deskpro256/DoggoLights/Images/packaged.jpeg

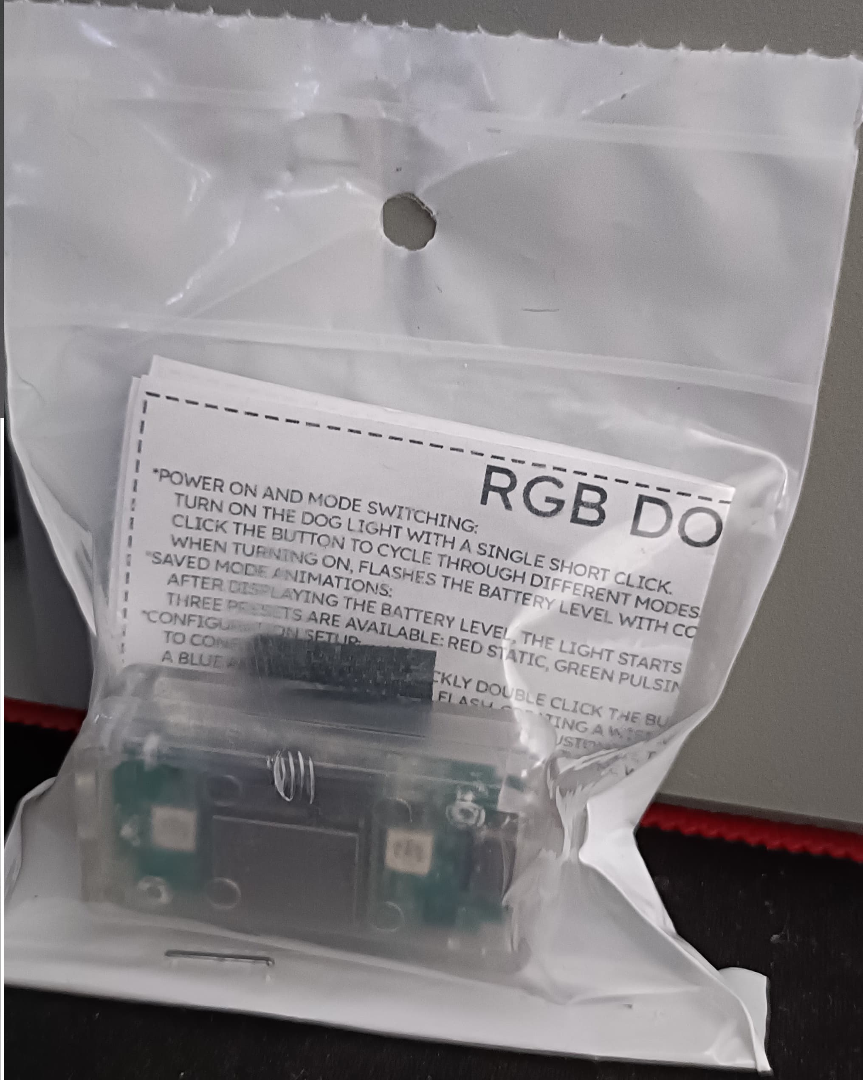
Images/packaged.jpeg
