deskpro256/DoggoLights/Images/WhatsApp Image 2024-01-11 at 19.58.03.jpeg

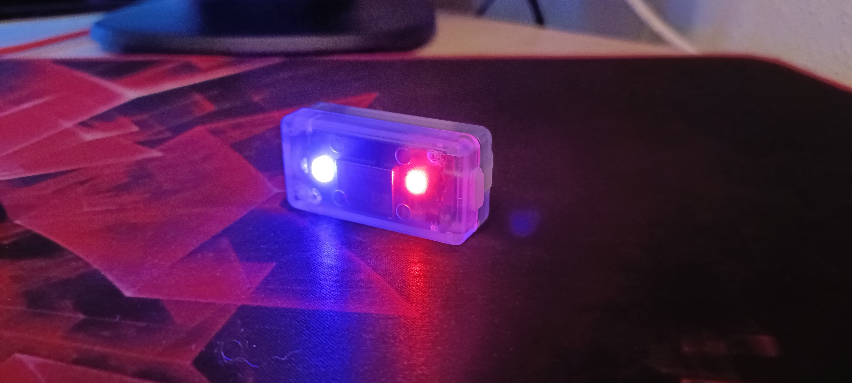
Images/WhatsApp Image 2024-01-11 at 19.58.03.jpeg
