deskpro256/DoggoLights/Hardware/Images/PCB-REV-1.png

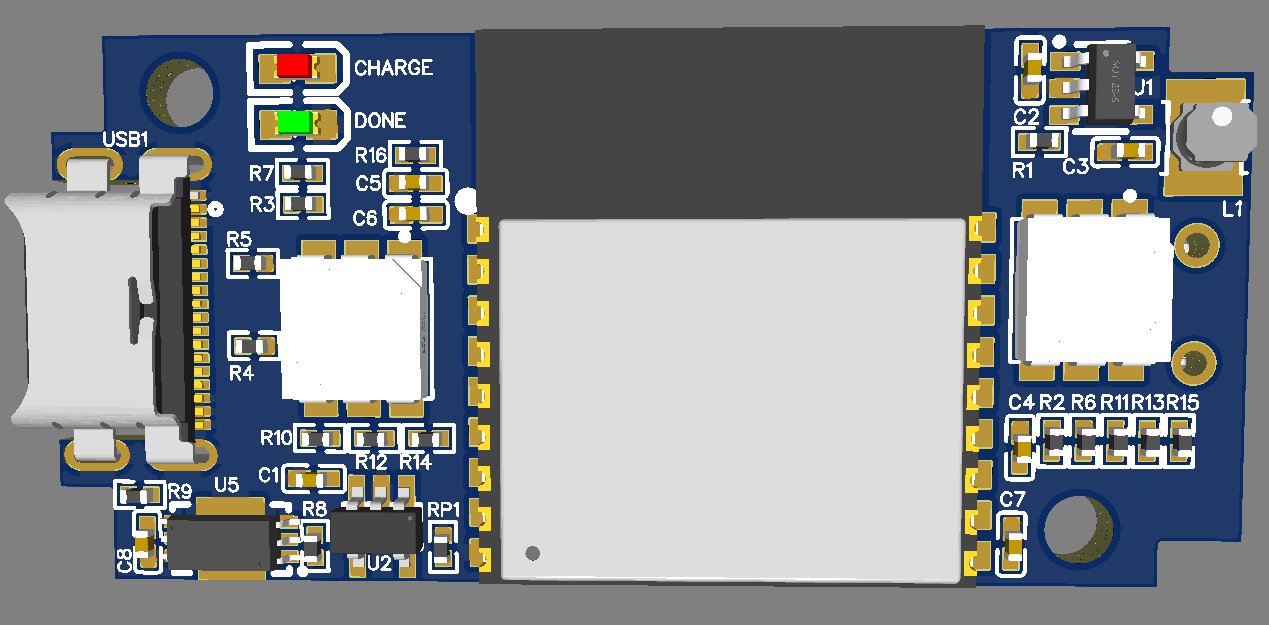
Hardware/Images/PCB-REV-1.png
