deskpro256/DoggoLights/Hardware/v2/2D-bot.png

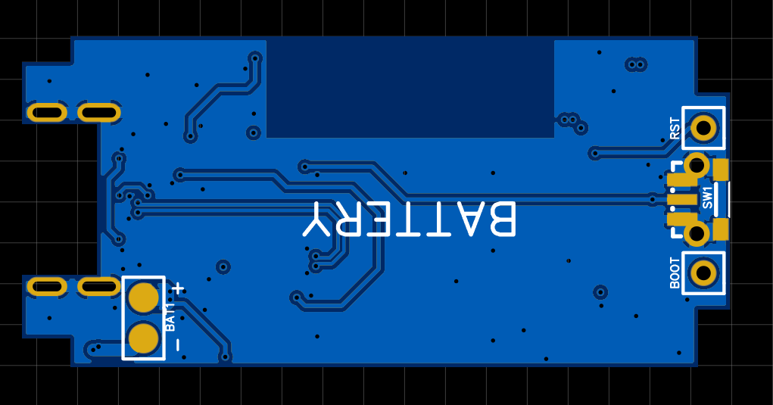
Hardware/v2/2D-bot.png
