deskpro256/DoggoLights/Hardware/v2/2D-top.png

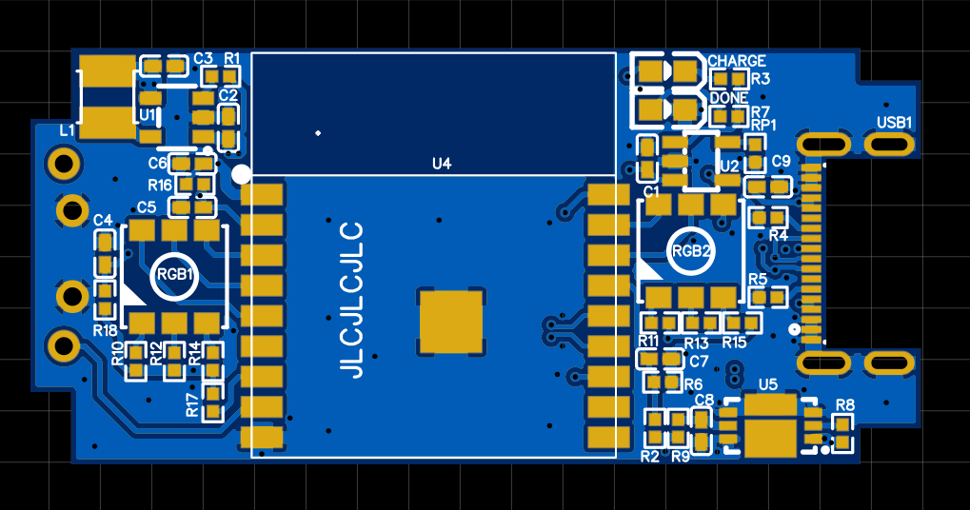
Hardware/v2/2D-top.png
