deskpro256/DoggoLights/Hardware/v2/3d-top-1.png

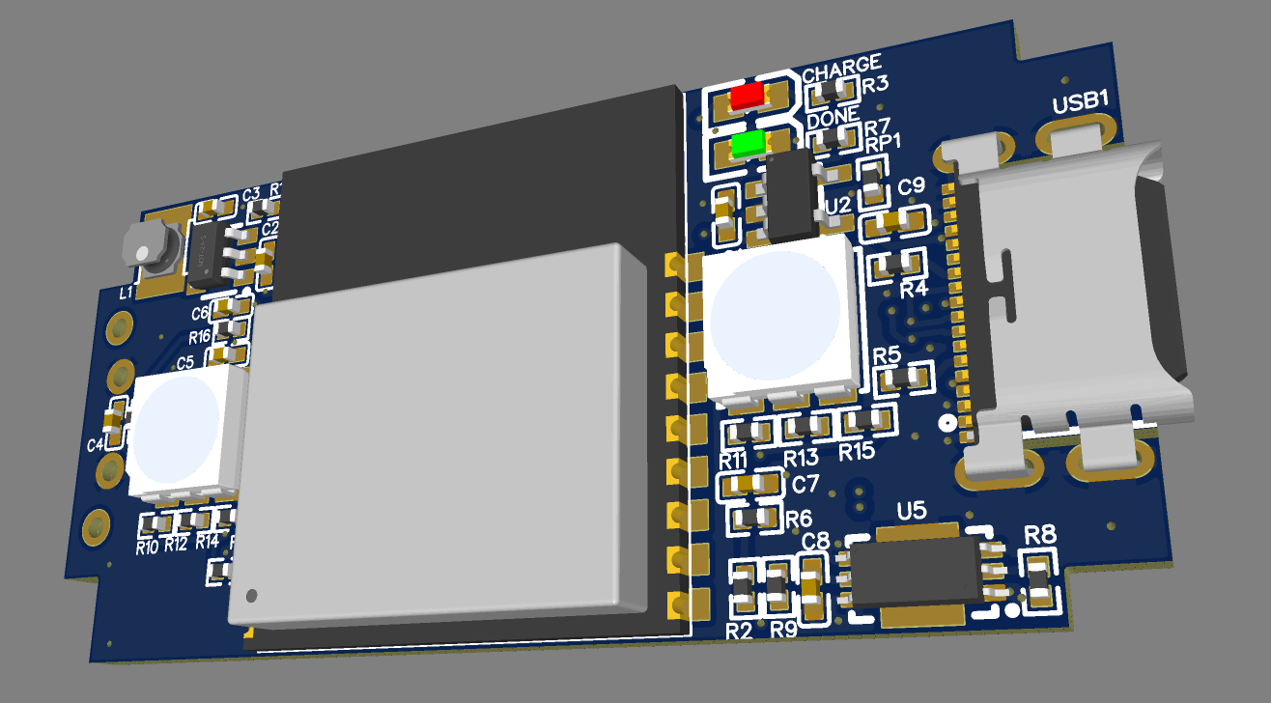
Hardware/v2/3d-top-1.png
