deskpro256/DoggoLights/Hardware/v2/3d-top-2.png

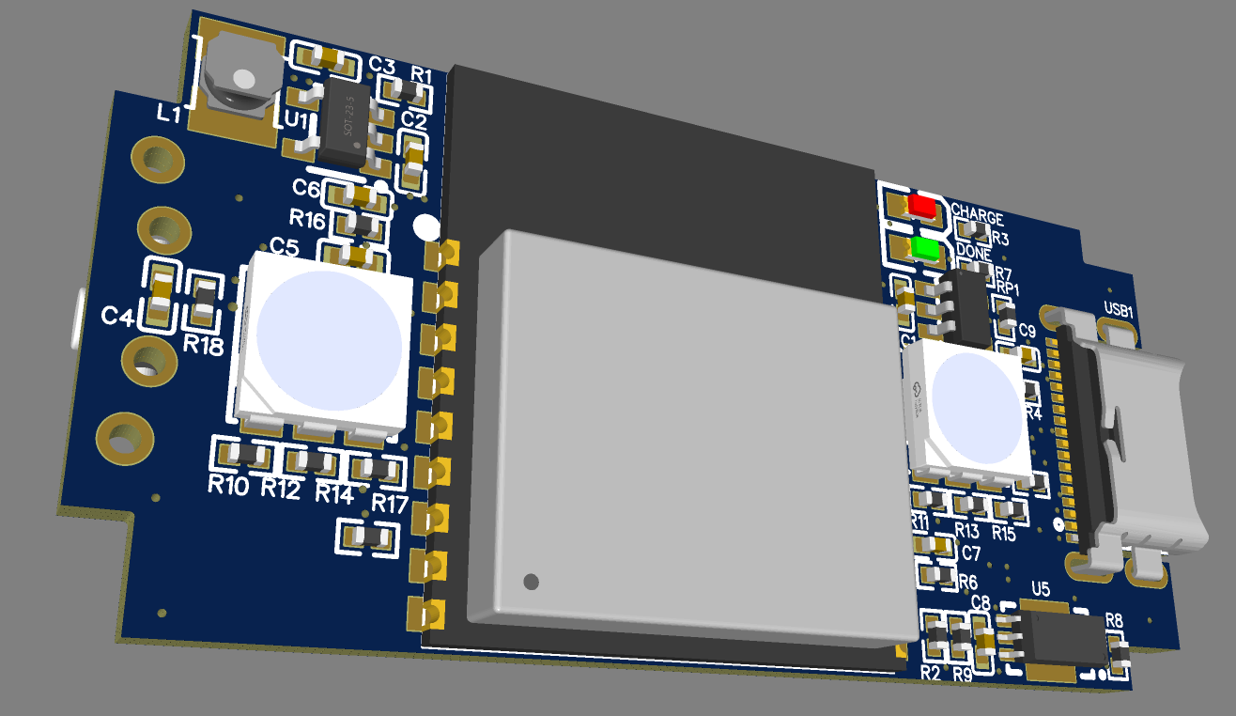
Hardware/v2/3d-top-2.png
