deskpro256/DoggoLights/Hardware/v2/Schematic_Doggo-Lights_2024-01-20.png

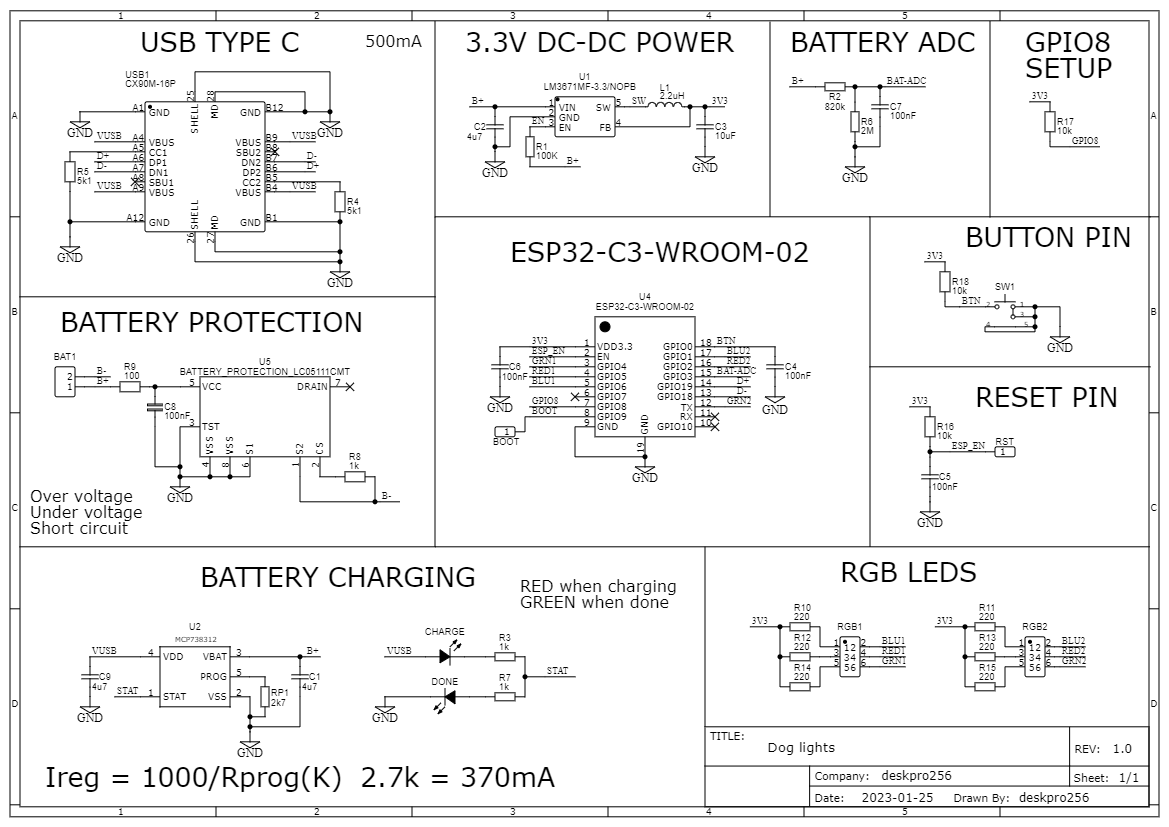
Hardware/v2/Schematic_Doggo-Lights_2024-01-20.png
