deskpro256/DoggoLights/Images/AI_doggo_w_light.png

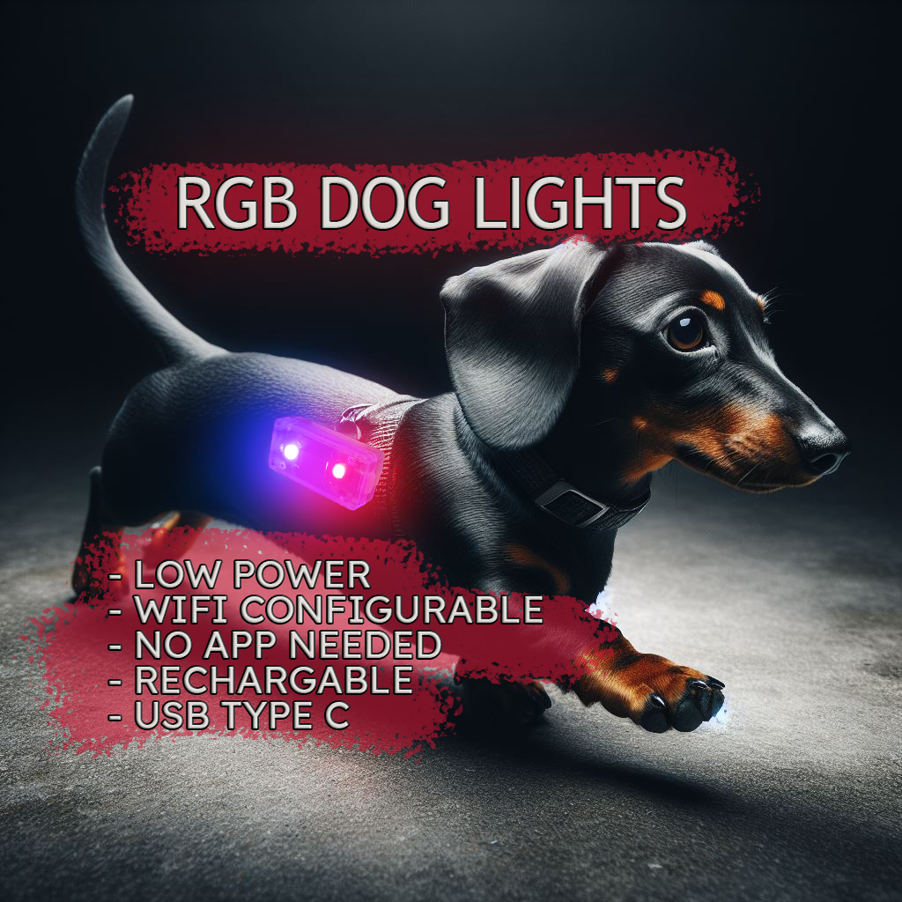
Images/AI_doggo_w_light.png
