deskpro256/DoggoLights/Images/dogLightsOrtoButton.png

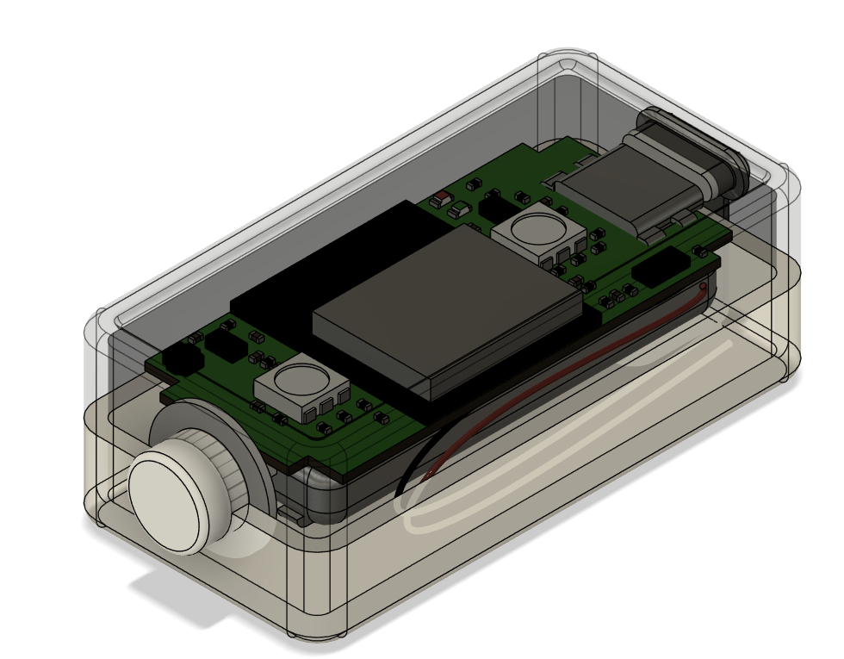
Images/dogLightsOrtoButton.png
