deskpro256/DoggoLights/Images/dogLightsOrtoUSB.png

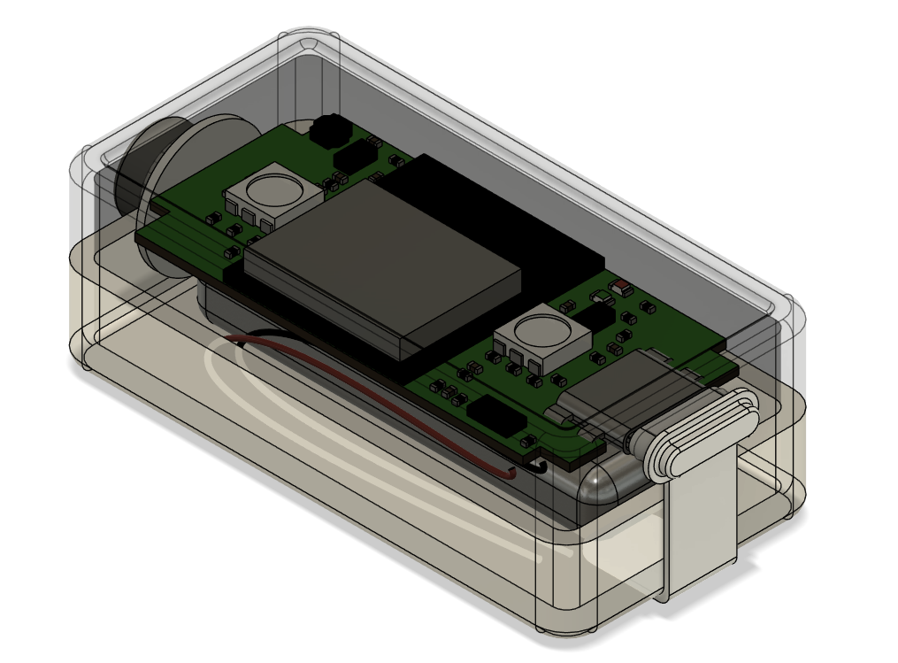
Images/dogLightsOrtoUSB.png
