deskpro256/DoggoLights/Images/dogLightsTop.png

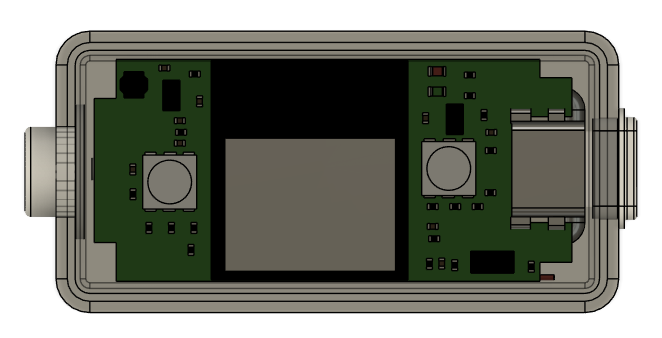
Images/dogLightsTop.png
