deskpro256/DoggoLights/Images/WhatsApp Image 2024-01-11 at 19.48.37.jpeg

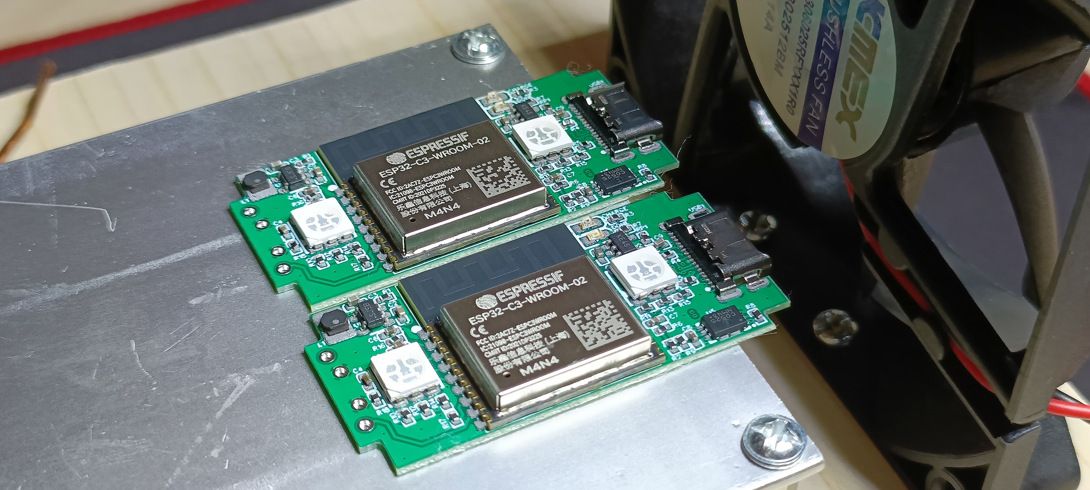
Images/WhatsApp Image 2024-01-11 at 19.48.37.jpeg
