deskpro256/DoggoLights/Images/WhatsApp Image 2024-01-20 at 23.52.01.jpeg

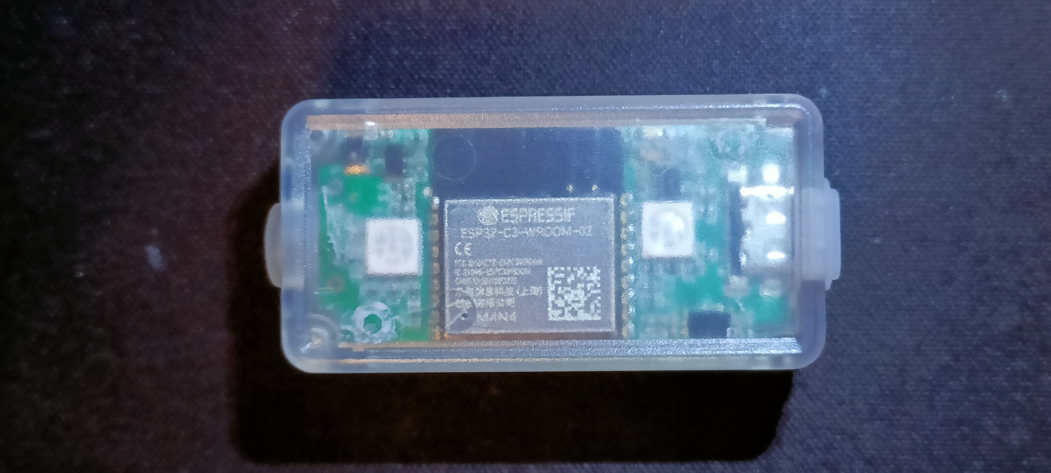
Images/WhatsApp Image 2024-01-20 at 23.52.01.jpeg
