deskpro256/DoggoLights/Specifications/SpecSheet.png

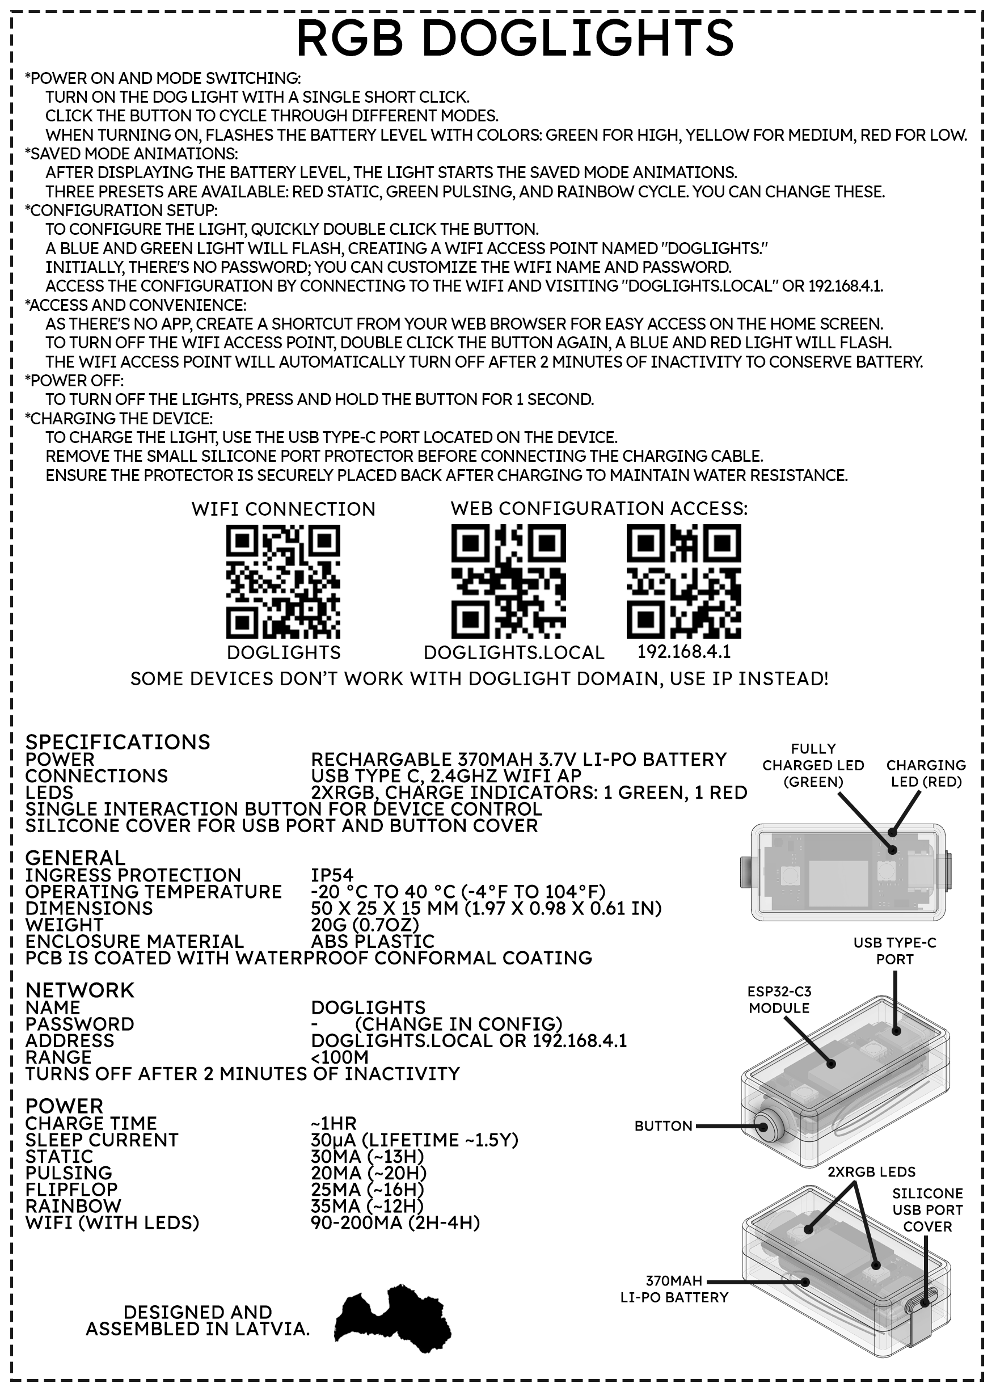
Specifications/SpecSheet.png
