deskpro256/DoggoLights/Hardware/v2/BOM_Doggo-Lights_2024-01-20.csv

ID | Name | Designator | Footprint | Quantity
1 | HDR-M-2.54_1x2 | BAT1 | HDR-M-2.54_1X2 | 1
2 | HDR-M-2.54_1x1 | BOOT,RST | HDR-M-2.54_1X1 | 2
3 | 4u7 | C1,C2,C9 | C0402 | 3
4 | 10uF | C3 | C0402 | 1
5 | 100nF | C4,C5,C6,C7,C8 | C0402 | 5
6 | LED-0805_R | CHARGE | LED-0603 | 1
7 | LED-0805_G | DONE | LED-0603 | 1
8 | 2.2uH | L1 | IND-SMD_L2.4-W2.4_NRH241XT | 1
9 | 100K | R1 | R0402 | 1
10 | 820k | R2 | R0402 | 1
11 | 1k | R3,R7,R8 | R0402 | 3
12 | 5k1 | R4,R5 | R0402 | 2
13 | 2M | R6 | R0402 | 1
14 | 100 | R9 | R0402 | 1
15 | 220 | R10,R11,R12,R13,R14,R15 | R0402 | 6
16 | 10k | R16,R17,R18 | R0402 | 3
17 | HY5050W-G01 | RGB1,RGB2 | LED-ARRAY-SMD_6P-L5.0-W5.0-P1.60-LS5.3-TL | 2
18 | 2k7 | RP1 | R0402 | 1
19 | TL3340AF160QGSCR | SW1 | SW-SMD_TL3340AF160QGSCR | 1
20 | LM3671MF-3.3/NOPB | U1 | SOT-23-5_L3.0-W1.7-P0.95-LS2.8-BR | 1
21 | MCP73831OT | U2 | SOT23-5L | 1
22 | ESP32--C3--WROOM--02 | U4 | FOOTPRINT-ESP32-C3-WROOM-02 | 1
23 | BATTERY_PROTECTION_LC05111CMT | U5 | LC05111CMT_FOOTPRINT | 1
24 | CX90M-16P | USB1 | USB-C-SMD_CX90M-16P | 1
