deskpro256/DoggoLights/Hardware/v2/DoggoLights.xlsx

Country of Origin may be different at time of shipment.
The HTSUS and ECCN information shown is for informational purposes only and is not a representation or warranty as to the accuracy or reliability of these classifications. All information is provided "as is" and is subject to change without notice. Any use made of the information provided is without recourse to Digi-Key and at the user's risk.
Index | Manufacturer Part Number | Manufacturer Name | Description | Availability | Stock Status | Attrition % | Requested Quantity 1 | Pack Quantity 1 | Pack Type 1 | Digi-Key Part Number 1 | Unit Price 1 | Extended Price 1 | Minimum Order Quantity 1 | Customer Reference | Requested Part Number | Lead Weeks | Datasheet | Reference Designator | US Import Tariff | Note | Part Status | RoHS Status | Moisture Sensitivity Level (MSL) | ECCN | HTSUS | Country of Origin | Environmental Information | Original Part numbers | Image
1 | ESP32-C3-WROOM-02-N4 | Espressif Systems | RF TXRX MODULE BT PCB TRACE SMD | 11,098 | In Stock |  | 1 | 1 | Cut Tape (CT) | 1965-ESP32-C3-WROOM-02-N4CT-ND | 1.74000 | €1.74 | 1 |  | 1965-ESP32-C3-WROOM-02-N4CT-ND | 8 | https://www.espressif.com/sites/default/files/documentation/esp32-c3-wroom-02_datasheet_en.pdf |  | May apply on shipments to the U.S. |  | Active | RoHS Compliant | 3 (168 Hours) | 5A992C | 8517.62.0090 | China |  | 1965-ESP32-C3-WROOM-02-N4CT-ND | https://mm.digikey.com/Volume0/opasdata/d220001/medias/images/5383/ESP32%C2%8D%C2%9DC3%C2%8D%C2%9DWROOM%C2%8D%C2%9D02.jpg
2 | MCP73831T-2ACI/OT | Microchip Technology | IC BATT CNTL LI-ION 1CEL SOT23-5 | 135,688 | In Stock |  | 1 | 1 | Cut Tape (CT) | MCP73831T-2ACI/OTCT-ND | 0.70000 | €0.70 | 1 |  | MCP73831T-2ACI/OTCT-ND | 6 | https://ww1.microchip.com/downloads/en/DeviceDoc/MCP73831-Family-Data-Sheet-DS20001984H.pdf |  | N/A |  | Active | ROHS3 Compliant | 1 (Unlimited) | EAR99 | 8542.39.0001 | Thailand | https://ww1.microchip.com/downloads/aemDocuments/documents/corporate-responsibilty/environmental/product-regulatory-information/Semiconductor_Prop_65_Statemen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|https://ww1.microchip.com/downloads/aemDocuments/documents/corporate-responsibilty/environmental/product-regulatory-information/Microchip_REACH_Statement.pdf|https://ww1.microchip.com/downloads/aemDocuments/documents/corporate-responsibilty/environmental/product-regulatory-information/Semiconductor_EnvCoC.pdf | MCP73831T-2ACI/OTCT-ND | https://mm.digikey.com/Volume0/opasdata/d220001/medias/images/2386/150%7EC04-091%7ECT%2C%20OT%7E5.JPG
3 | LC05111C25MTTTG | onsemi | IC BATT PROT LI-ION 1CELL 6WDFN | 3,893 | In Stock - Non-Stock |  | 1 | 1 | Cut Tape (CT) | 488-LC05111C25MTTTGCT-ND | 1.36000 | €1.36 | 1 |  | 488-LC05111C25MTTTGCT-ND | 32 |  |  | May apply on shipments to the U.S. |  | Obsolete | ROHS3 Compliant | 3 (168 Hours) | EAR99 | 8542.39.0001 | China | https://www.onsemi.com/PowerSolutions/MaterialComposition.do?export=pdf&opnId=LC05111C25MTTTG|https://www.onsemi.com/site/pdf/RoHS-statement.pdf | 488-LC05111C25MTTTGCT-ND
4 | CX90M-16P | Hirose Electric Co Ltd | CONN RCP USB3.2 TYP C 24P BRD ED | 734 | In Stock |  | 1 | 1 | Cut Tape (CT) | H126318CT-ND | 2.40000 | €2.40 | 1 |  | H126318CT-ND | 12 | https://www.hirose.com/product/document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 |  | N/A |  | Active | RoHS Compliant | 1 (Unlimited) | EAR99 | 8536.69.4040 | South Korea |  | H126318CT-ND | https://mm.digikey.com/Volume0/opasdata/d220001/medias/images/1133/CX90M-16P.jpg
5 | LM3671MF-3.3/NOPB | Texas Instruments | IC REG BUCK 3.3V 600MA SOT23-5 | 3,167 | In Stock |  | 1 | 1 | Cut Tape (CT) | LM3671MF-3.3/NOPBCT-ND | 1.52000 | €1.52 | 1 |  | LM3671MF-3.3/NOPBCT-ND | 6 | https://www.ti.com/general/docs/suppproductinfo.tsp?distId=10 |  | N/A |  | Active | ROHS3 Compliant | 1 (Unlimited) | EAR99 | 8542.39.0001 | Malaysia |  | LM3671MF-3.3/NOPBCT-ND | https://mm.digikey.com/Volume0/opasdata/d220001/medias/images/4180/296%7E4073253-4%7EDBV%7E5.JPG
6 | TL3340AF160QG | E-Switch | SWITCH TACTILE SPST-NO 0.05A 12V | 165,068 | In Stock |  | 1 | 1 | Cut Tape (CT) | EG4627CT-ND | 0.49000 | €0.49 | 1 |  | EG4627CT-ND | 15 | https://sten-eswitch-13110800-production.s3.amazonaws.com/system/asset/product_line/data_sheet/164/TL3340.pdf |  | May apply on shipments to the U.S. |  | Active | ROHS3 Compliant | 1 (Unlimited) | EAR99 | 8536.50.9031 | China | https://sten-eswitch-13110800-production.s3.amazonaws.com/system/asset/document/274/original/RoHS.pdf|http://rohs.e-switch.com/rohs/Series_TL3340_Cert_revA.pdf | EG4627CT-ND | https://mm.digikey.com/Volume0/opasdata/d220001/medias/images/587/TL3340AF160QG.JPG
7 | LSXNE2424KKT2R2MN | Taiyo Yuden | FIXED IND 2.2UH 970MA 180MOHM SM | 2,419 | In Stock |  | 1 | 1 | Cut Tape (CT) | 587-LSXNE2424KKT2R2MNCT-ND | 0.17000 | €0.17 | 1 |  | 587-LSXNE2424KKT2R2MNCT-ND | 8 |  |  | N/A |  | Active | ROHS3 Compliant | 1 (Unlimited) | EAR99 | 8504.50.8000 | Philippines |  | 587-LSXNE2424KKT2R2MNCT-ND | https://mm.digikey.com/Volume0/opasdata/d220001/medias/images/4226/MFG_LSXNE2424KKT2R2MN.jpg
8 | 1551BCLR | Hammond Manufacturing | BOX ABS TRN CL 1.970"L X 0.980"W | 603 | In Stock |  | 1 | 1 | Bag | HM1622-ND | 3.10000 | €3.10 | 1 |  | HM1622-ND | 4 | https://www.hammfg.com/electronics/small-case/plastic/1551mini |  | N/A |  | Active | ROHS3 Compliant | Not Applicable | EAR99 | 3923.10.9000 | United States | https://cdn.hammfg.com/compliance/reach/reach-219-letter.pdf | HM1622-ND | https://mm.digikey.com/Volume0/opasdata/d220001/medias/images/2531/1551BCLR.jpg
9 | CR0402-FX-1002GLF | Bourns Inc. | RES SMD 10K OHM 1% 1/16W 0402 | 3,207,648 | In Stock |  | 10 | 10 | Cut Tape (CT) | CR0402-FX-1002GLFCT-ND | 0.01100 | €0.11 | 1 |  | CR0402-FX-1002GLFCT-ND | 11 | https://www.bourns.com/docs/product-datasheets/cr.pdf?sfvrsn=574d41f6_14 |  | N/A |  | Active | ROHS3 Compliant | 1 (Unlimited) | EAR99 | 8533.21.0030 | Taiwan | https://www.bourns.com/docs/rohs-content/bourns-reach-letter.pdf|https://www.bourns.com/docs/Product-MDS/cr0402_mds.pdf|https://www.bourns.com/docs/rohs-cofc/crx_coc.pdf?sfvrsn=db3a74f6_10 | CR0402-FX-1002GLFCT-ND | https://mm.digikey.com/Volume0/opasdata/d220001/medias/images/505/CR0402-(1005-Metric).jpg
10 | RC0402FR-07100RL | YAGEO | RES 100 OHM 1% 1/16W 0402 | 4,746,828 | In Stock |  | 10 | 10 | Cut Tape (CT) | 311-100LRCT-ND | 0.01400 | €0.14 | 1 |  | 311-100LRCT-ND | 18 | https://www.yageo.com/upload/media/product/app/datasheet/rchip/pyu-rc_group_51_rohs_l.pdf |  | May apply on shipments to the U.S. |  | Active | ROHS3 Compliant | 1 (Unlimited) | EAR99 | 8533.21.0030 | Taiwan | https://www.yageo.com/en/Download/Index/certificates#rchip | 311-100LRCT-ND | https://mm.digikey.com/Volume0/opasdata/d220001/medias/images/4849/13_0402-%281005-metric%29.jpg
11 | WR04X2200FTL | Walsin Technology Corporation | RES 220 OHM 1% 1/16W 0402 | 252,377 | In Stock |  | 10 | 10 | Cut Tape (CT) | 1292-WR04X2200FTLCT-ND | 0.00900 | €0.09 | 1 |  | 1292-WR04X2200FTLCT-ND | 26 | http://www.passivecomponent.com/wp-content/uploads/chipR/ASC_WR.pdf |  | May apply on shipments to the U.S. |  | Active | ROHS3 Compliant | 1 (Unlimited) | EAR99 | 8533.21.0030 | China | http://www.passivecomponent.com/download/reach_rohs_compliance_declaration-2/?wpdmdl=1343 | 1292-WR04X2200FTLCT-ND | https://mm.digikey.com/Volume0/opasdata/d220001/medias/images/4850/738_0201-RMCF-Series.jpg
12 | RC0402FR-07820KL | YAGEO | RES 820K OHM 1% 1/16W 0402 | 860,214 | In Stock |  | 10 | 10 | Cut Tape (CT) | YAG3240CT-ND | 0.01400 | €0.14 | 1 |  | YAG3240CT-ND | 18 | https://www.yageo.com/upload/media/product/app/datasheet/rchip/pyu-rc_group_51_rohs_l.pdf |  | May apply on shipments to the U.S. |  | Active | ROHS3 Compliant | 1 (Unlimited) | EAR99 | 8533.21.0030 | Taiwan | https://www.yageo.com/en/Download/Index/certificates#rchip | YAG3240CT-ND | https://mm.digikey.com/Volume0/opasdata/d220001/medias/images/4849/13_0402-%281005-metric%29.jpg
13 | RC0402FR-07100KL | YAGEO | RES 100K OHM 1% 1/16W 0402 | 24,625,766 | In Stock |  | 10 | 10 | Cut Tape (CT) | 311-100KLRCT-ND | 0.01400 | €0.14 | 1 |  | 311-100KLRCT-ND | 18 | https://www.yageo.com/upload/media/product/app/datasheet/rchip/pyu-rc_group_51_rohs_l.pdf |  | May apply on shipments to the U.S. |  | Active | ROHS3 Compliant | 1 (Unlimited) | EAR99 | 8533.21.0030 | Taiwan | https://www.yageo.com/en/Download/Index/certificates#rchip | 311-100KLRCT-ND | https://mm.digikey.com/Volume0/opasdata/d220001/medias/images/4849/13_0402-%281005-metric%29.jpg
14 | RC0402FR-071KL | YAGEO | RES 1K OHM 1% 1/16W 0402 | 16,645,282 | In Stock |  | 10 | 10 | Cut Tape (CT) | 311-1.00KLRCT-ND | 0.01400 | €0.14 | 1 |  | 311-1.00KLRCT-ND | 18 | https://www.yageo.com/upload/media/product/app/datasheet/rchip/pyu-rc_group_51_rohs_l.pdf |  | N/A |  | Active | ROHS3 Compliant | 1 (Unlimited) | EAR99 | 8533.21.0030 | Taiwan | https://www.yageo.com/en/Download/Index/certificates#rchip | 311-1.00KLRCT-ND | https://mm.digikey.com/Volume0/opasdata/d220001/medias/images/4849/13_0402-%281005-metric%29.jpg
15 | RC0402FR-135K1L | YAGEO | RES 5.1K OHM 1% 1/16W 0402 | 277,986 | In Stock |  | 10 | 10 | Cut Tape (CT) | 13-RC0402FR-135K1LCT-ND | 0.01400 | €0.14 | 1 |  | 13-RC0402FR-135K1LCT-ND | 18 | https://www.yageo.com/upload/media/product/productsearch/datasheet/rchip/PYu-RC_Group_51_RoHS_L_12.pdf |  | N/A |  | Active | ROHS3 Compliant | 1 (Unlimited) | EAR99 | 8533.21.0030 | Taiwan | https://www.yageo.com/en/Download/Index/certificates#rchip | 13-RC0402FR-135K1LCT-ND | https://mm.digikey.com/Volume0/opasdata/d220001/medias/images/4849/13_0402-(1005-metric).jpg
16 | RMCF0402JT2M00 | Stackpole Electronics Inc | RES 2M OHM 5% 1/16W 0402 | 25,244 | In Stock |  | 10 | 10 | Cut Tape (CT) | 738-RMCF0402JT2M00CT-ND | 0.01500 | €0.15 | 1 |  | 738-RMCF0402JT2M00CT-ND | 16 | https://www.seielect.com/catalog/sei-rmcf_rmcp.pdf |  | N/A |  | Active | ROHS3 Compliant | 1 (Unlimited) | EAR99 | 8533.21.0030 | China | https://www.seielect.com/catalog/cert-of-compliance.pdf|https://www.seielect.com/catalog/reach.pdf|https://www.seielect.com/catalog/SEI-RoHS_Compliance_Status.pdf | 738-RMCF0402JT2M00CT-ND | https://mm.digikey.com/Volume0/opasdata/d220001/medias/images/2597/MFG_RMC SERIES.jpg
17 | B1911PG--20D000514U1930 | Harvatek Corporation | LED GREEN DIFFUSED 0603 SMD | 2,094 | In Stock |  | 1 | 1 | Cut Tape (CT) | 3147-B1911PG--20D000514U1930CT-ND | 0.09000 | €0.09 | 1 |  | 3147-B1911PG--20D000514U1930CT-ND | 8 | https://mm.digikey.com/Volume0/opasdata/d220001/medias/docus/3777/B1911PG--20D000514U1930.pdf |  | N/A |  | Active | RoHS Compliant | 2A (4 Weeks) | EAR99 | 8541.41.0000 | Taiwan |  | 3147-B1911PG--20D000514U1930CT-ND | https://mm.digikey.com/Volume0/opasdata/d220001/medias/images/4095/MFG_B1911.jpg
18 | B1911USD-20D000114U1930 | Harvatek Corporation | LED RED DIFFUSED 0603 SMD | 1,991 | In Stock |  | 1 | 1 | Cut Tape (CT) | 3147-B1911USD-20D000114U1930CT-ND | 0.09000 | €0.09 | 1 |  | 3147-B1911USD-20D000114U1930CT-ND | 8 | https://mm.digikey.com/Volume0/opasdata/d220001/medias/docus/3694/B1911USD-20D000114U1930.pdf |  | N/A |  | Active | RoHS Compliant | 2A (4 Weeks) | EAR99 | 8541.41.0000 | Taiwan |  | 3147-B1911USD-20D000114U1930CT-ND | https://mm.digikey.com/Volume0/opasdata/d220001/medias/images/4095/MFG_B1911.jpg
19 | CL05A475MP5NRNC | Samsung Electro-Mechanics | CAP CER 4.7UF 10V X5R 0402 | 2,785,522 | In Stock |  | 10 | 10 | Cut Tape (CT) | 1276-1482-1-ND | 0.05900 | €0.59 | 1 |  | 1276-1482-1-ND | 22 | https://mm.digikey.com/Volume0/opasdata/d220001/medias/docus/863/CL05A475MP5NRNC_Spec.pdf |  | N/A |  | Active | ROHS3 Compliant | 1 (Unlimited) | EAR99 | 8532.24.0020 | Philippines | https://www.samsungsem.com/files/fileDown.do?key=ed1dfdfa-645e-4252-b707-17f9b1502dd1|https://www.samsungsem.com/global/support/certificate/product-stewardship.do | 1276-1482-1-ND | https://mm.digikey.com/Volume0/opasdata/d220001/medias/images/2537/Ceramic-Capacitor-CL-Series.jpg
20 | GRM155R61A106ME11D | Murata Electronics | CAP CER 10UF 10V X5R 0402 | 112,063 | In Stock |  | 10 | 10 | Cut Tape (CT) | 490-GRM155R61A106ME11DCT-ND | 0.08300 | €0.83 | 1 |  | 490-GRM155R61A106ME11DCT-ND | 19 | https://search.murata.co.jp/Ceramy/image/img/A01X/G101/ENG/GRM155R61A106ME11-01A.pdf |  | N/A |  | Active | ROHS3 Compliant | 1 (Unlimited) | EAR99 | 8532.24.0020 | Japan |  | 490-GRM155R61A106ME11DCT-ND | https://mm.digikey.com/Volume0/opasdata/d220001/medias/images/5447/490-Ceramic-Capacitor-Tan-Field.jpg
21 | CL05A104KA5NNNC | Samsung Electro-Mechanics | CAP CER 0.1UF 25V X5R 0402 | 13,573,803 | In Stock |  | 10 | 10 | Cut Tape (CT) | 1276-1043-1-ND | 0.00900 | €0.09 | 1 |  | 1276-1043-1-ND | 22 | https://mm.digikey.com/Volume0/opasdata/d220001/medias/docus/503/CL05A104KA5NNNC.pdf |  | May apply on shipments to the U.S. |  | Active | ROHS3 Compliant | 1 (Unlimited) | EAR99 | 8532.24.0020 | China | https://www.samsungsem.com/files/fileDown.do?key=ed1dfdfa-645e-4252-b707-17f9b1502dd1|https://www.samsungsem.com/global/support/certificate/product-stewardship.do | 1276-1043-1-ND | https://mm.digikey.com/Volume0/opasdata/d220001/medias/images/2537/Ceramic-Capacitor-CL-Series.jpg
22 | 150505M173300 | Würth Elektronik | LED RGB CLEAR 6PLCC SMD | 33,311 | In Stock |  | 2 | 2 | Cut Tape (CT) | 732-12000-1-ND | 0.58000 | €1.16 | 1 |  | 732-12000-1-ND | 13 | https://www.we-online.com/katalog/datasheet/150505M173300.pdf |  | N/A |  | Active | ROHS3 Compliant | 3 (168 Hours) | EAR99 | 8541.41.0000 | China | https://mm.digikey.com/Volume0/opasdata/d220001/medias/docus/744/Certificate_of_Compliance_ROHS.pdf | 732-12000-1-ND | https://mm.digikey.com/Volume0/opasdata/d220001/medias/images/861/MFG_150505M173300.jpg
