deskpro256/DoggoLights/(commit log)

2023-11-11 First commit, adding the WIP files to repo.
    [min_spiffs.csv]
2023-11-30 Finalized WEB design. Implemented WEB form parsing for ESP32. Uses HSL values for color saving and using. Updated order of operations.
2023-11-30 Redid button handling so it's easier to use. Fixed web get values not updating.
    [ESP32-Lights.ino, battery-handling.ino, config.ino, handle-button.ino, light-controlling.ino, wifi.ino]
2024-01-11 Fixed battery ADC to read properly and show correct colors according to %. Added a timer for WIFI to turn off after 2 minutes of inactivity.
    [ESP32-Lights.ino, battery-handling.ino, handle-button.ino, light-controlling.ino, wifi.ino]
2024-01-20 Fixed battery voltage and percent reading. Added some images and updated schematic, BOM etc. Added Digikey parts list.
    [BOM_Doggo-Lights_2024-01-20.csv, DoggoLights.csv, DoggoLights.xlsx, PickAndPlace_PCB_Doggo-Lights_2024-01-20.csv]
2024-02-20 Added info for assembling in readme. Made Spectrum bigger in WebUI
2024-08-07 Enabled some debug info when using cable. Updated index.html to use buttons instead of canvas.
2024-08-16 Working on OTA updating. Added home setwork form for OTA updates. MAC address getting and adding to device name.
2026-04-15 Refactoring and reimplementing features using esp-idf. Still a WIP
    [partitions.csv]
2026-04-15 Logging of actions, factory resets, handling of on the fly requests, connection loss indication, password hiding.
    [app_main.c, leds.c, storage.c, web_server.c]
2026-04-16 Non linear battery reading, button press time changes and turn on/off fixes
    [app_config.h, app_main.c, battery.c, button.c]
2026-04-17 OTA led indication and update fixes
    [ota_pull.c, storage.c, web_server.c]
2026-04-17 Button task fail fix
    [button.c, rpc.c, web_server.c]
